DreamingRaven/RavenSLA/Design Resources/CircuitDiagrams2.png

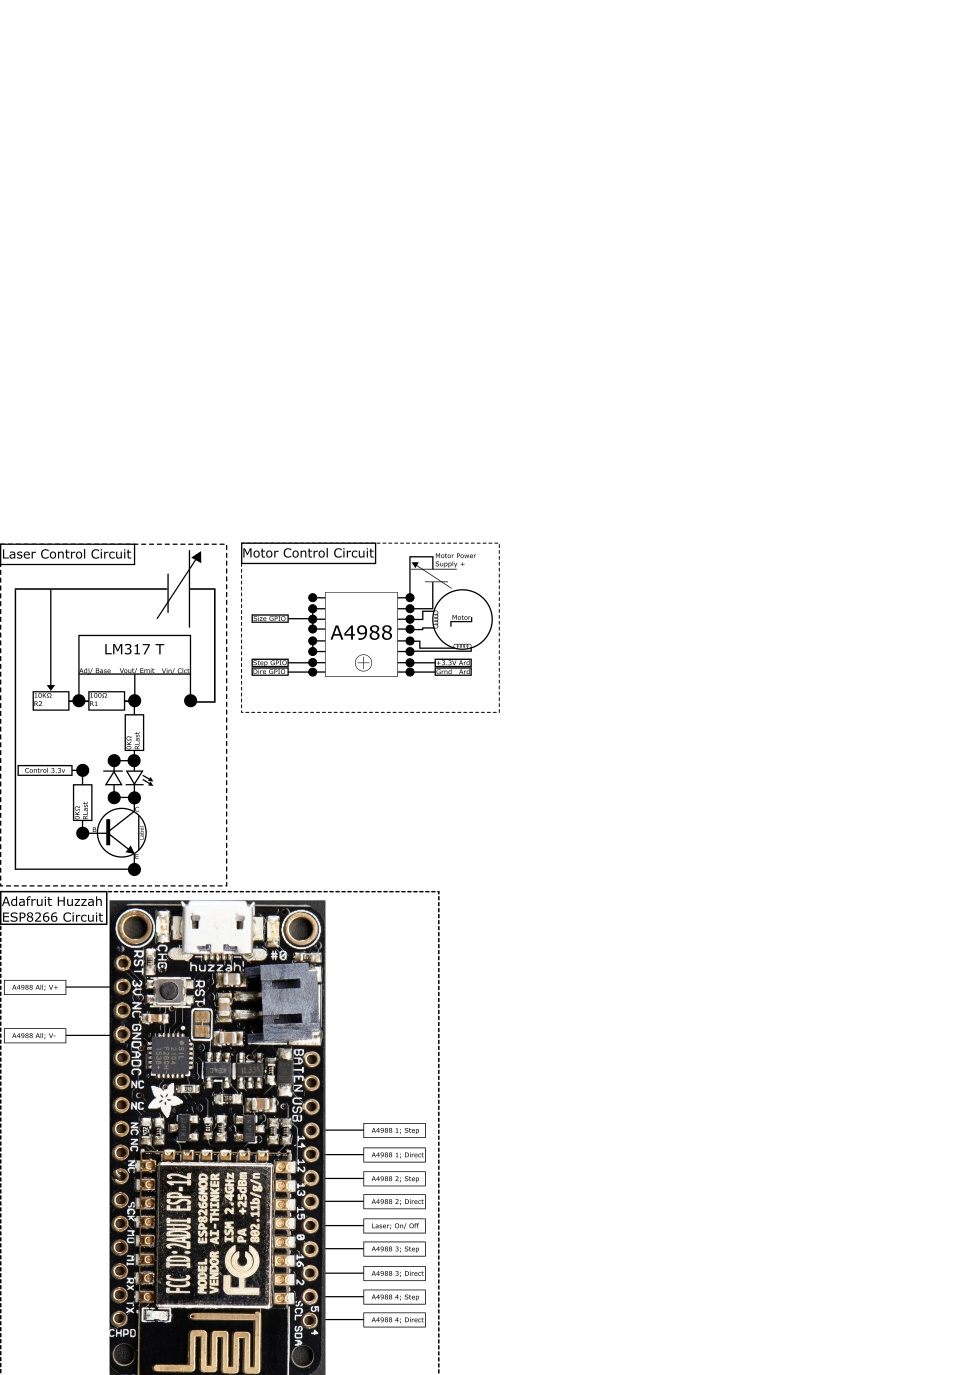
Design Resources/CircuitDiagrams2.png
