DreamingRaven/RavenSLA/Design Resources/CircuitDiagrams.png

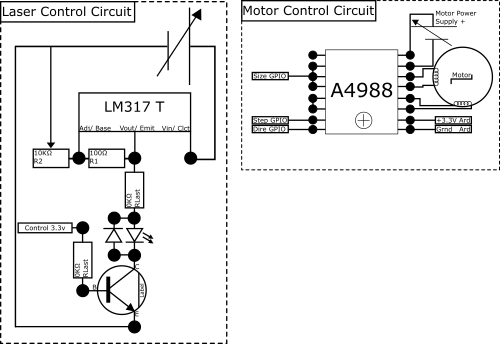
Design Resources/CircuitDiagrams.png
