DreamingRaven/RavenSLA/parser/RawPackman.h

//
// George Onoufriou : 26/02/2017.
//

#ifndef PARSER_RAWPACKMAN_H
#define PARSER_RAWPACKMAN_H


class RawPackman {
private:
    int socketRaw;
public:
    void init();
};


#endif //PARSER_RAWPACKMAN_H
